DiamondLightSource/ptRecorder/docs/Hardware/Box/NewHole1.jpg

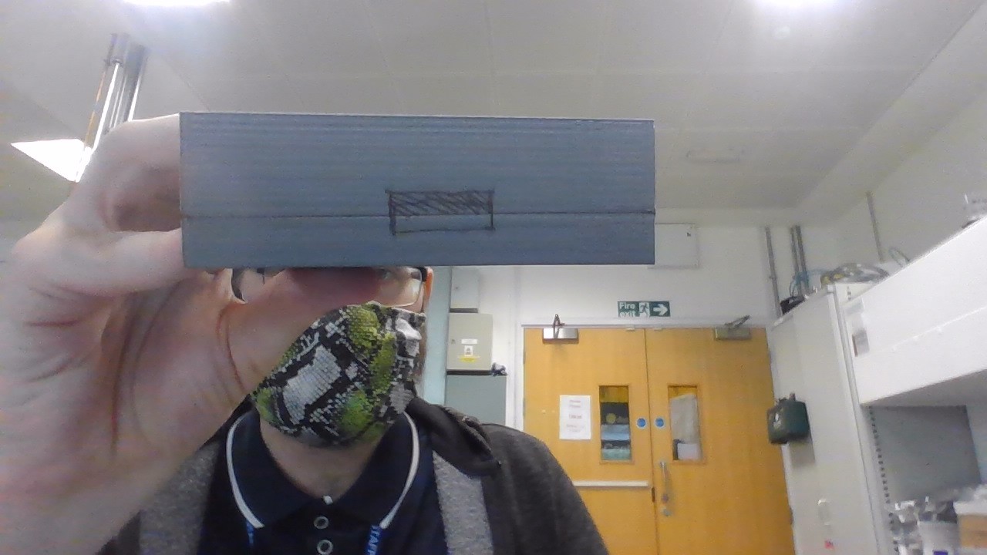
docs/Hardware/Box/NewHole1.jpg
