DiamondLightSource/ptRecorder/docs/Hardware/Box/NewHole2.jpg

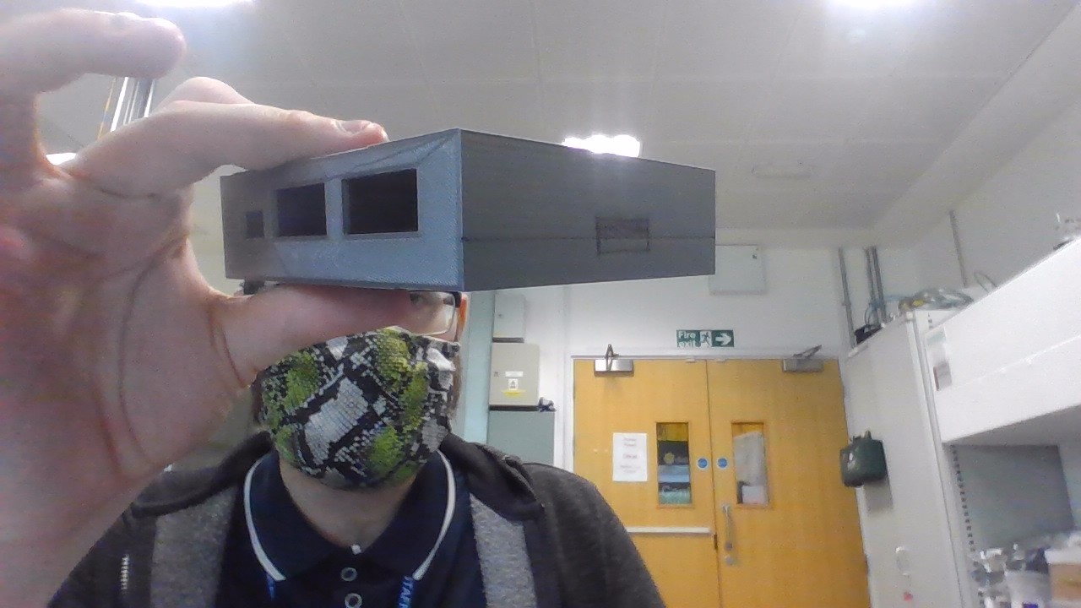
docs/Hardware/Box/NewHole2.jpg
