DiamondLightSource/ptRecorder/README.md

# ptRecorder
Pressure and Temperature recorder created by Daniel Brennand and comissioned by DLS Vacuum Dept.

### DLS Contacts

- Hugo Shiers
- Giles Knap
