DiamondLightSource/ptRecorder/docs/Hardware/Box/NewHoleDimensions.pdf

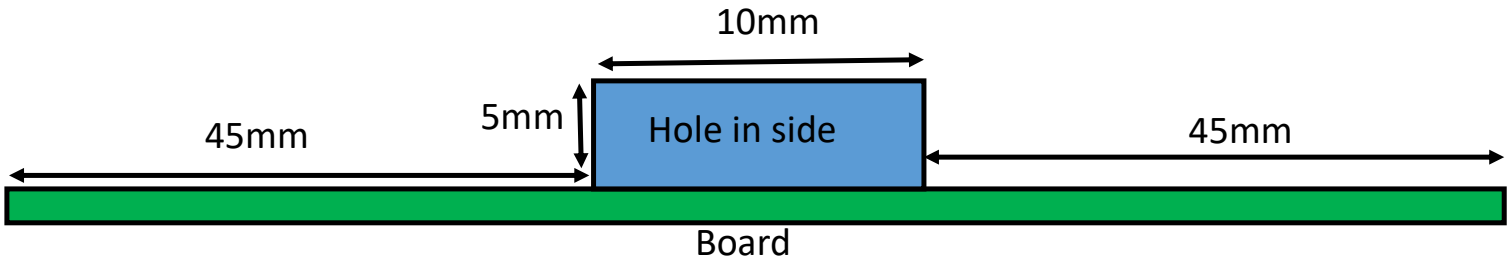
[picture p6: figure]
Board; Hole in side
