DiamondLightSource/ptRecorder/docs/Hardware/Box/Drawing1.pdf

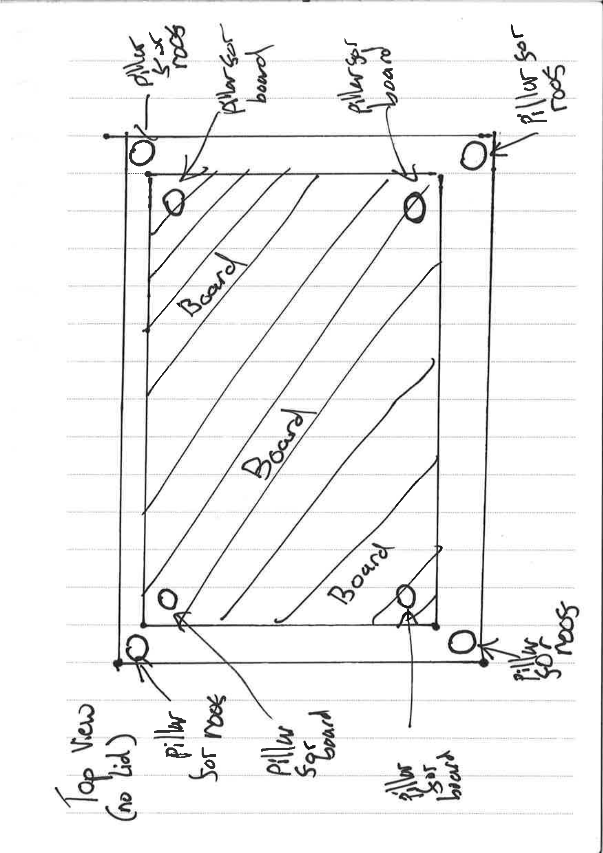
[picture p7: page 1]
