DiamondLightSource/ptRecorder/docs/Hardware/Box/Drawing2.pdf

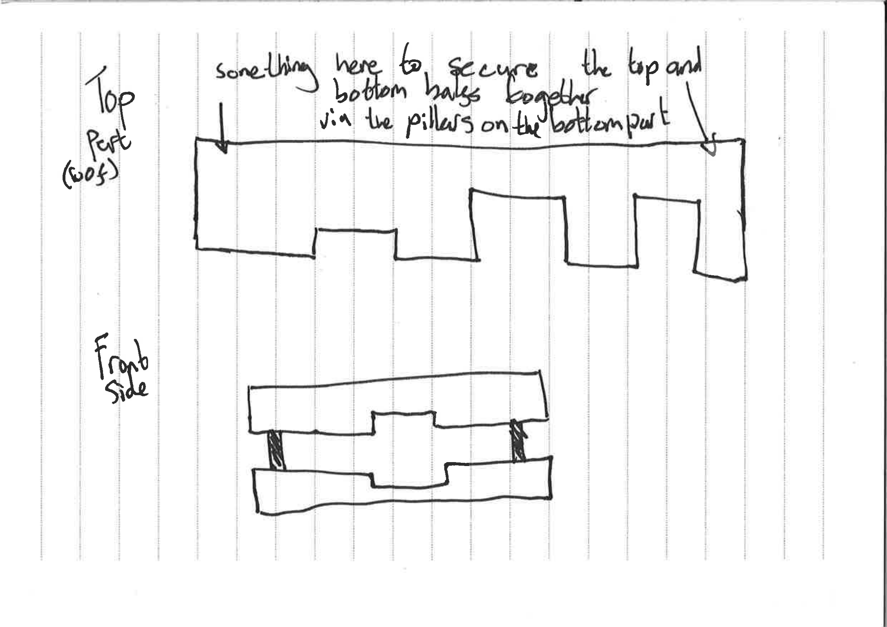
[picture p8: page 1]
