DiamondLightSource/ptRecorder/docs/Hardware/Box/Drawing3.pdf

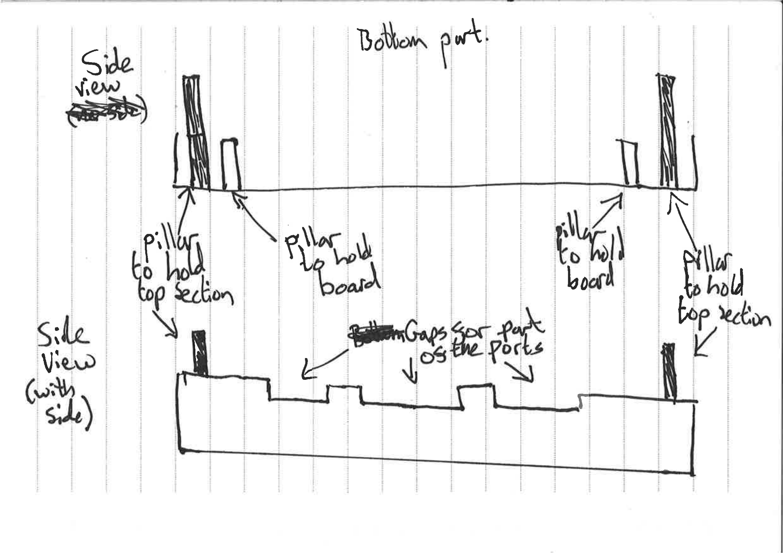
[picture p9: page 1]
