DiamondLightSource/ptRecorder/docs/Hardware/Parts&BOM/BOM.xlsx

Part Name | MFR Part number | Quantity | Designator | Value
ADC | ADS8332IBPWR | 2 | IC4, IC5
Reference IC | MCP1541T-I/TT | 2 | IC1, IC6
9 Pin connector | 9661127601 | 4 | J3, J4, J5, J5
Thermocouple Amp | MAX31855KASA+ | 2 | IC2, IC3
Thermocouple Conector | 381-7564 | 2 | J1, J2
Zener Diode | ESD12VD3B-TP | 14 | D1, D2, D3, D4, D5, D6, D7, D8, D9, D10, D11, D12, D13, D14
Resistor (1k) | ERJ-3GEYJ102V | 4 | R1, R16, R31, R32 | 1k
Resistor (2k) | RMCF0402FT2K00 | 14 | R2, R5, R7, R9, R11, R13, R15, R17, R20, R22, R24, R26, R28, R30 | 2k
Resistor (3k) | ERJ-6GEYJ302V | 14 | R3, R4, R6, R8, R10, R12, R14, R18, R19, R21, R23, R25, R27, R29 | 3k
Capacitor (0.1uF) | C0402C104K4PACTU | 2 | C3, C4 | 0.1uF
Capacitor (100pF) | C0402C101K5RAC7867 | 14 | C7, C8, C9, C10, C11, C12, C13, C16, C17, C18, C19, C20, C21, C22 | 100pF
Capacitor (10uF) | CL21A106KPCLQNC | 4 | C5, C6, C14, C15 | 10uF
Capacitor (1uF) | C0603C105K8RACTU | 4 | C1, C2, C23, C24 | 1uF
Capacitor (0.01uF) | CL05B103KB5VPJC | 2 | C25, C26 | 0.01uF
Capacitor (22uF) | CL21X226MRQNNNE | 2 | C27, C28 | 22uF
Seeduino Xiao | 1E4-D57-5A2 | 1 | U1
