DiamondLightSource/ptRecorder/docs/Hardware/Parts&BOM/Parts List.xlsx

Part Name | Value | MFR | MFR Part number | Supplier | Supplier Part Number | Quantity | Cost per unit* | Cost per board* | Designator | Details | Link
ADC |  | Texas Instruments | ADS8332IBPWR | DigiKey | 296-42323-1-ND | 2 | £7.37 | £14.74 | IC4, IC5 |  | https://www.digikey.co.uk/en/products/detail/texas-instruments/ADS8332IBPWR/5356909
Reference IC |  | Microchip | MCP1541T-I/TT | RS | 698-9047 | 2 | £0.70 | £1.40 | IC1, IC6 |  | https://uk.rs-online.com/web/p/voltage-references/6989047/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
9 Pin connector |  | Harting | 9661127601 | RS | 160-3060 | 4 | £3.48 | £13.92 | J3, J4, J5, J5 |  | https://uk.rs-online.com/web/p/d-sub-connectors/1603060
Thermocouple Amp |  | Maxim Integrated | MAX31855KASA+ | Mouser | 700-MAX31855KASA+ | 2 | £4.63 | £9.26 | IC2, IC3 |  | https://www.mouser.co.uk/ProductDetail/Maxim-Integrated/MAX31855KASA+/?qs=ffX8NcjNb2QF5YDuL5Qj5g==
Thermocouple Conector |  | RS | 381-7564 | RS | 381-7564 | 2 | £3.08 | £6.16 | J1, J2 |  | https://uk.rs-online.com/web/p/sensor-accessories/3817564
Zener Diode |  | Micro Commercial Co | ESD12VD3B-TP | DigiKey | ESD12VD3B-TPMSCT-ND | 14 | £0.17 | £2.38 | D1, D2, D3, D4, D5, D6, D7, D8, D9, D10, D11, D12, D13, D14 |  | https://www.digikey.co.uk/en/products/detail/micro-commercial-co/ESD12VD3B-TP/2783860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
Resistor | 1k | Bourns Inc. | CR0402AFX-1001GLF | DigiKey | 118-CR0402AFX-1001GLFTR-ND | 2 | £0.07 | £0.14 | R1, R16 |  | https://www.digikey.co.uk/en/products/detail/bourns-inc/CR0402AFX-1001GLF/12091350
Resistor | 2k | Stackpole Electronics Inc | RMCF0402FT2K00 | DigiKey | RMCF0402FT2K00CT-ND | 14 | £0.01 | £0.14 | R2, R5, R7, R9, R11, R13, R15, R17, R20, R22, R24, R26, R28, R30 |  | https://www.digikey.co.uk/en/products/detail/stackpole-electronics-inc/RMCF0402FT2K00/1761524
Resistor | 3k | Stackpole Electronics Inc | RMCF0402FT3K00 | DigiKey | RMCF0402FT3K00CT-ND | 14 | £0.07 | £0.98 | R3, R4, R6, R8, R10, R12, R14, R18, R19, R21, R23, R25, R27, R29 |  | https://www.digikey.co.uk/en/products/detail/stackpole-electronics-inc/RMCF0402FT3K00/2417444
Capacitor | 0.1uF | KEMET | C0402C104K4PACTU | DigiKey | 399-7762-1-ND | 2 | £0.03 | £0.06 | C3, C4 |  | https://www.digikey.co.uk/en/products/detail/kemet/C0402C104K4PACTU/2196232
Capacitor | 100pF | KEMET | C0402C101K5RAC7867 | DigiKey | 399-15291-1-ND | 14 | £0.01 | £0.14 | C7, C8, C9, C10, C11, C12, C13, C16, C17, C18, C19, C20, C21, C22 |  | https://www.digikey.co.uk/en/products/detail/kemet/C0402C101K5RAC7867/2269209
Capacitor | 10uF | Samsung Electro-Mechanics | CL05A106MP8NUB8 | DigiKey | 1276-6830-1-ND | 4 | £0.27 | £1.08 | C5, C6, C14, C15 |  | https://www.digikey.co.uk/en/products/detail/samsung-electro-mechanics/CL05A106MP8NUB8/5961314
Capacitor | 1uF | Samsung Electro-Mechanics | CL05A105KO5NNNC | DigiKey | 1276-1067-1-ND | 4 | £0.07 | £0.28 | C1, C2, C23, C24 |  | https://www.digikey.co.uk/en/products/detail/samsung-electro-mechanics/CL05A105KO5NNNC/3886725
Capacitor | 0.01uF | Samsung Electro-Mechanics | CL05B103KB5VPJC | DigiKey | 1276-CL05B103KB5VPJCCT-ND | 2 | £0.03 | £0.06 | C25, C26 |  | https://www.digikey.co.uk/en/products/detail/samsung-electro-mechanics/CL05B103KB5VPJC/11487809
Capacitor | 22uF | AVX Corporation | 04026D226MAT2A | DigiKey | 478-9839-1-ND | 2 | £0.49 | £0.98 | C27, C28 |  | https://www.digikey.co.uk/en/products/detail/avx-corporation/04026D226MAT2A/5964920
Seeduino Xiao |  | Seeduino | 1E4-D57-5A2 | UnmannedTech | 1E4-D57-5A2 | 1 | £4.49 | £4.49 | U1 |  | https://www.unmannedtechshop.co.uk/product/seeeduino-xiao-arduino-microcontroller/
 |  |  |  |  |  |  | Total: | £56.21
*Assuming an order of 14 boards
