DiamondLightSource/ptRecorder/docs/Hardware/Parts&BOM/Quick-teck BOM.xls

 |  | BOM list
Date: 11 Aug 2021
Qty | Reference Designator | Item Description | Supplier | Supplier Part no. | Manufacturer | Manufacturer Part no. | Comment
2 | IC4, IC5 | ADC | DigiKey | 296-42323-1-ND | Texas Instruments | ADS8332IBPWR
2 | IC1, IC6 | Reference IC | RS | 698-9047 | Microchip | MCP1541T-I/TT
4 | J3, J4, J5, J6 | 9 Pin connector | RS | 160-3060 | Harting | 9661127601
2 | IC2, IC3 | Thermocouple Amp | Mouser | 700-MAX31855KASA+ | Maxim Integrated | MAX31855KASA+
2 | J1, J2 | Thermocouple Conector | RS | 381-7564 | RS | 381-7564
14 | D1, D2, D3, D4, D5, D6, D7, D8, D9, D10, D11, D12, D13, D14 | Zener Diode | DigiKey | ESD12VD3B-TPMSCT-ND | Micro Commercial Co | ESD12VD3B-TP
4 | R1, R16, R31, R32 | Resistor | DigiKey | P1.0KGCT-ND | Panasonic Electronic Components | ERJ-3GEYJ102V | 1k
14 | R2, R5, R7, R9, R11, R13, R15, R17, R20, R22, R24, R26, R28, R30 | Resistor | DigiKey | RMCF0402FT2K00CT-ND | Stackpole Electronics Inc | RMCF0402FT2K00 | 2k
14 | R3, R4, R6, R8, R10, R12, R14, R18, R19, R21, R23, R25, R27, R29 | Resistor | DigiKey | P3.0KACT-ND | Panasonic Electronic Components | ERJ-6GEYJ302V | 3k
2 | C3, C4 | Capacitor | DigiKey | 399-7762-1-ND | KEMET | C0402C104K4PACTU | 0.1uF
14 | C7, C8, C9, C10, C11, C12, C13, C16, C17, C18, C19, C20, C21, C22 | Capacitor | DigiKey | 399-15291-1-ND | KEMET | C0402C101K5RAC7867 | 100pF
4 | C5, C6, C14, C15 | Capacitor | DigiKey | 1276-2402-1-ND | Samsung Electro-Mechanics | CL21A106KPCLQNC | 10uF
4 | C1, C2, C23, C24 | Capacitor | DigiKey | 399-11133-1-ND | KEMET | C0603C105K8RACTU | 1uF
2 | C25, C26 | Capacitor | DigiKey | 1276-CL05B103KB5VPJCCT-ND | Samsung Electro-Mechanics | CL05B103KB5VPJC | 0.01uF
2 | C27, C28 | Capacitor | DigiKey | 1276-1202-1-ND | Samsung Electro-Mechanics | CL21X226MRQNNNE | 22uF
1 | U1 | Seeduino Xiao | UnmannedTech | 1E4-D57-5A2 | Seeduino | 1E4-D57-5A2 | Will be provided
BOM lines |  | 16
Total components qty: |  | 85
Notes: 1. Please use this template to ask for assembly and/or components sourcing quotes. 2. You don't need to provide the 'Manufacturer' and 'Manufacturer part no.' information, if you use Quick-teck as the supplier(input 'Quick-teck in the 'Supplier' cell') 3. Quick-teck China factory have over 1500 different components in stock. These parts are most common and popular used in our China factory site.The average price for these components is just one third of Europe suppliers. The real time in stock information can be found from: http://www.quick-teck.co.uk/ElectronicElement/eeList.php 4. Any miss information or different format BOM file may result in additional engineering charges.
