DiamondLightSource/ptRecorder/docs/Hardware/Parts&BOM/Quotes.xlsx

Boards: | 14
 |  | Place | Total (Including Shipping) | Delivery Time | Online or Email | Manufacturing | Assembly | Components | Per Board
 |  | PCB Pool | £2025.72 | 16WD | Online | £20.50 | £54.24 | £69.95 | £144.69
 |  | Quick Tec | £1220.46 | 4-5Weeks | Email | £15.28 | £18.38 | £53.45 | £87.11
 |  | PCB Train | £2277.65 | 15WD | Online | £30.57 | £76.29 | £55.83 | £162.69 | W/o seed and thermo connector
 |  | HiTechCircuits | £976.19 | 3-4Weeks | Email | £5.05 | £0.71 | £45.10 | £50.86 | Possibly need to add import making it 1171.43 leading to 83.67
