DiamondLightSource/ptRecorder/docs/Hardware/DrawingFiles/9PinConnectorDimensions.pdf

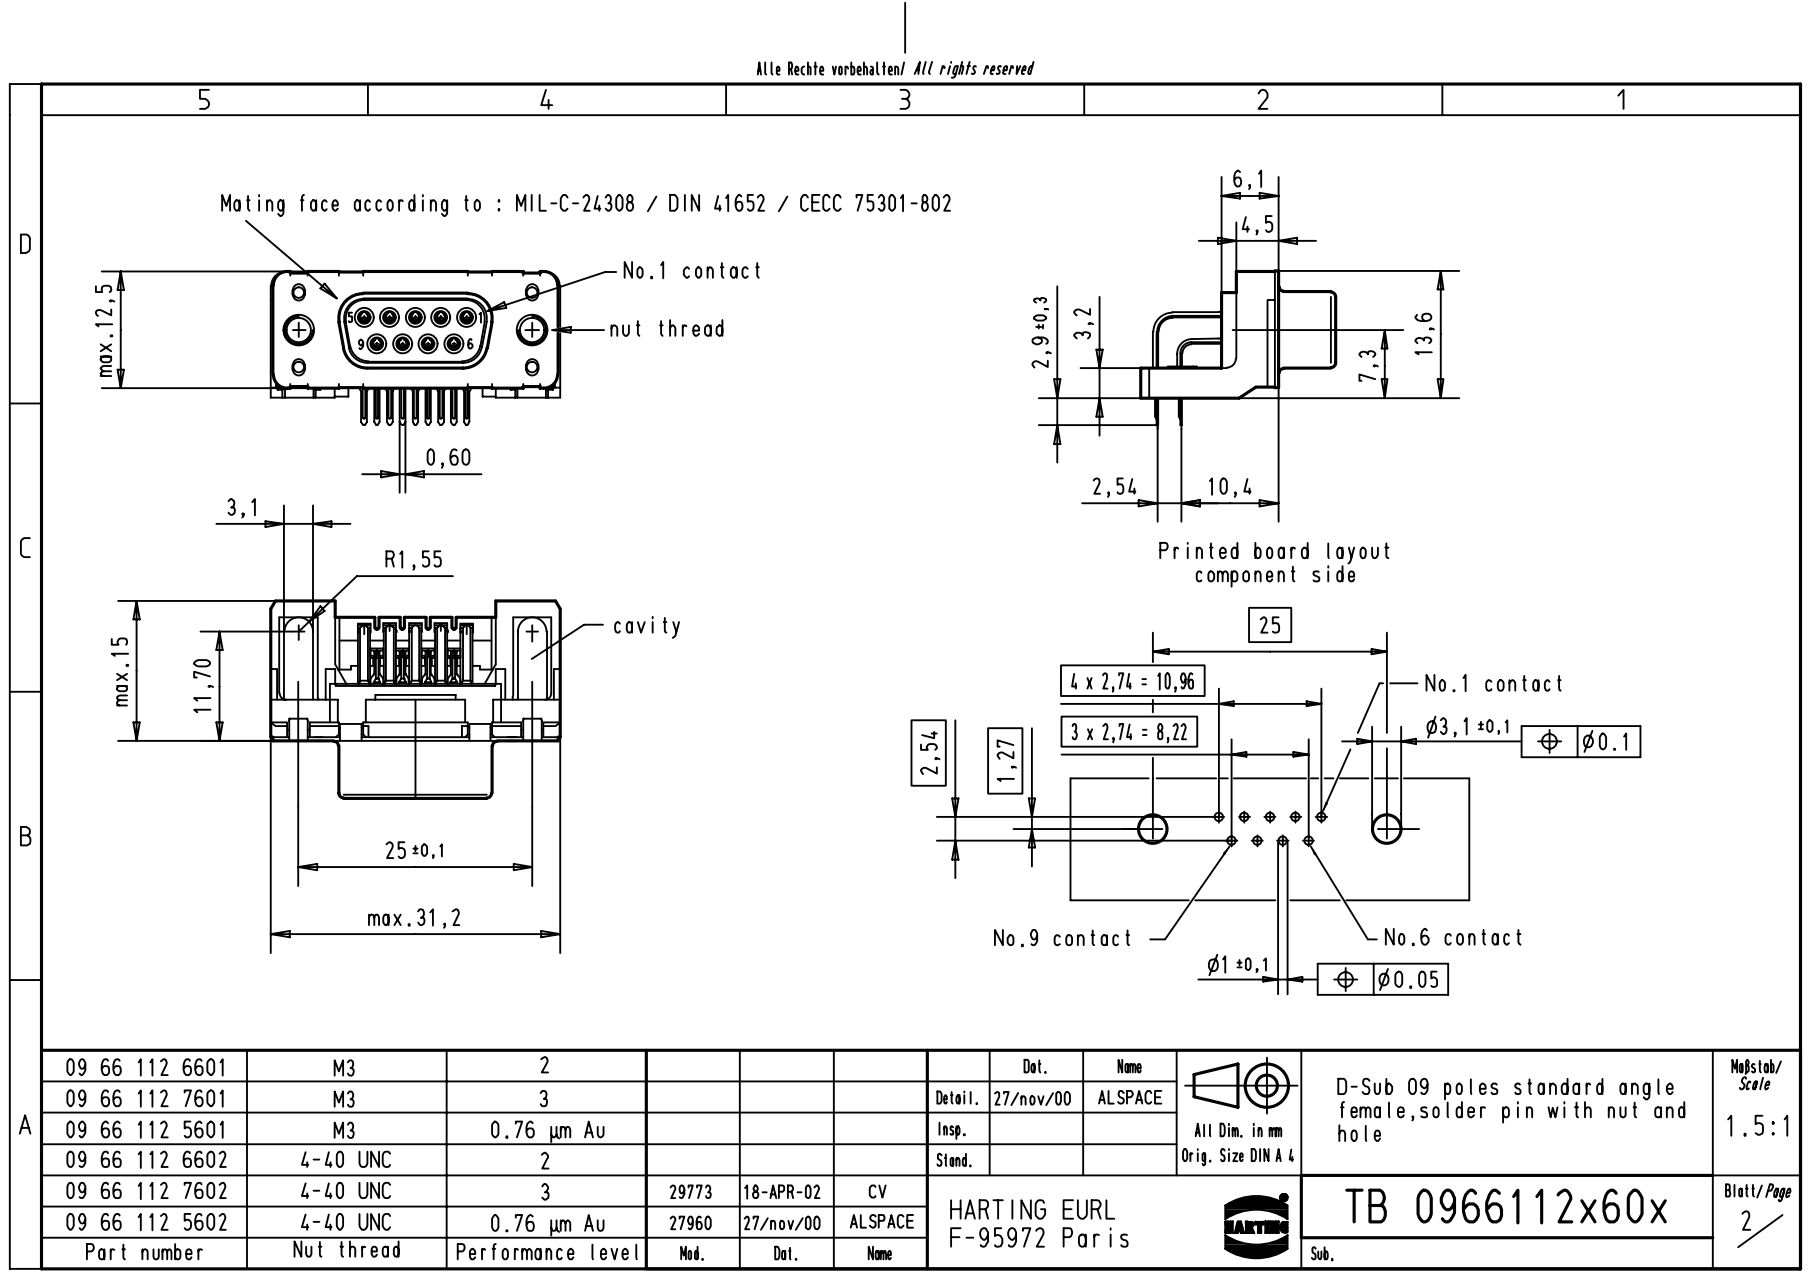
[picture p15: page 1]
