DiamondLightSource/ptRecorder/docs/Hardware/KiCadFiles/DataAqBoardV1.1.kicad_pcb

## KiCad design docs/Hardware/KiCadFiles/DataAqBoardV1.1.kicad_pcb (2021-11-04)

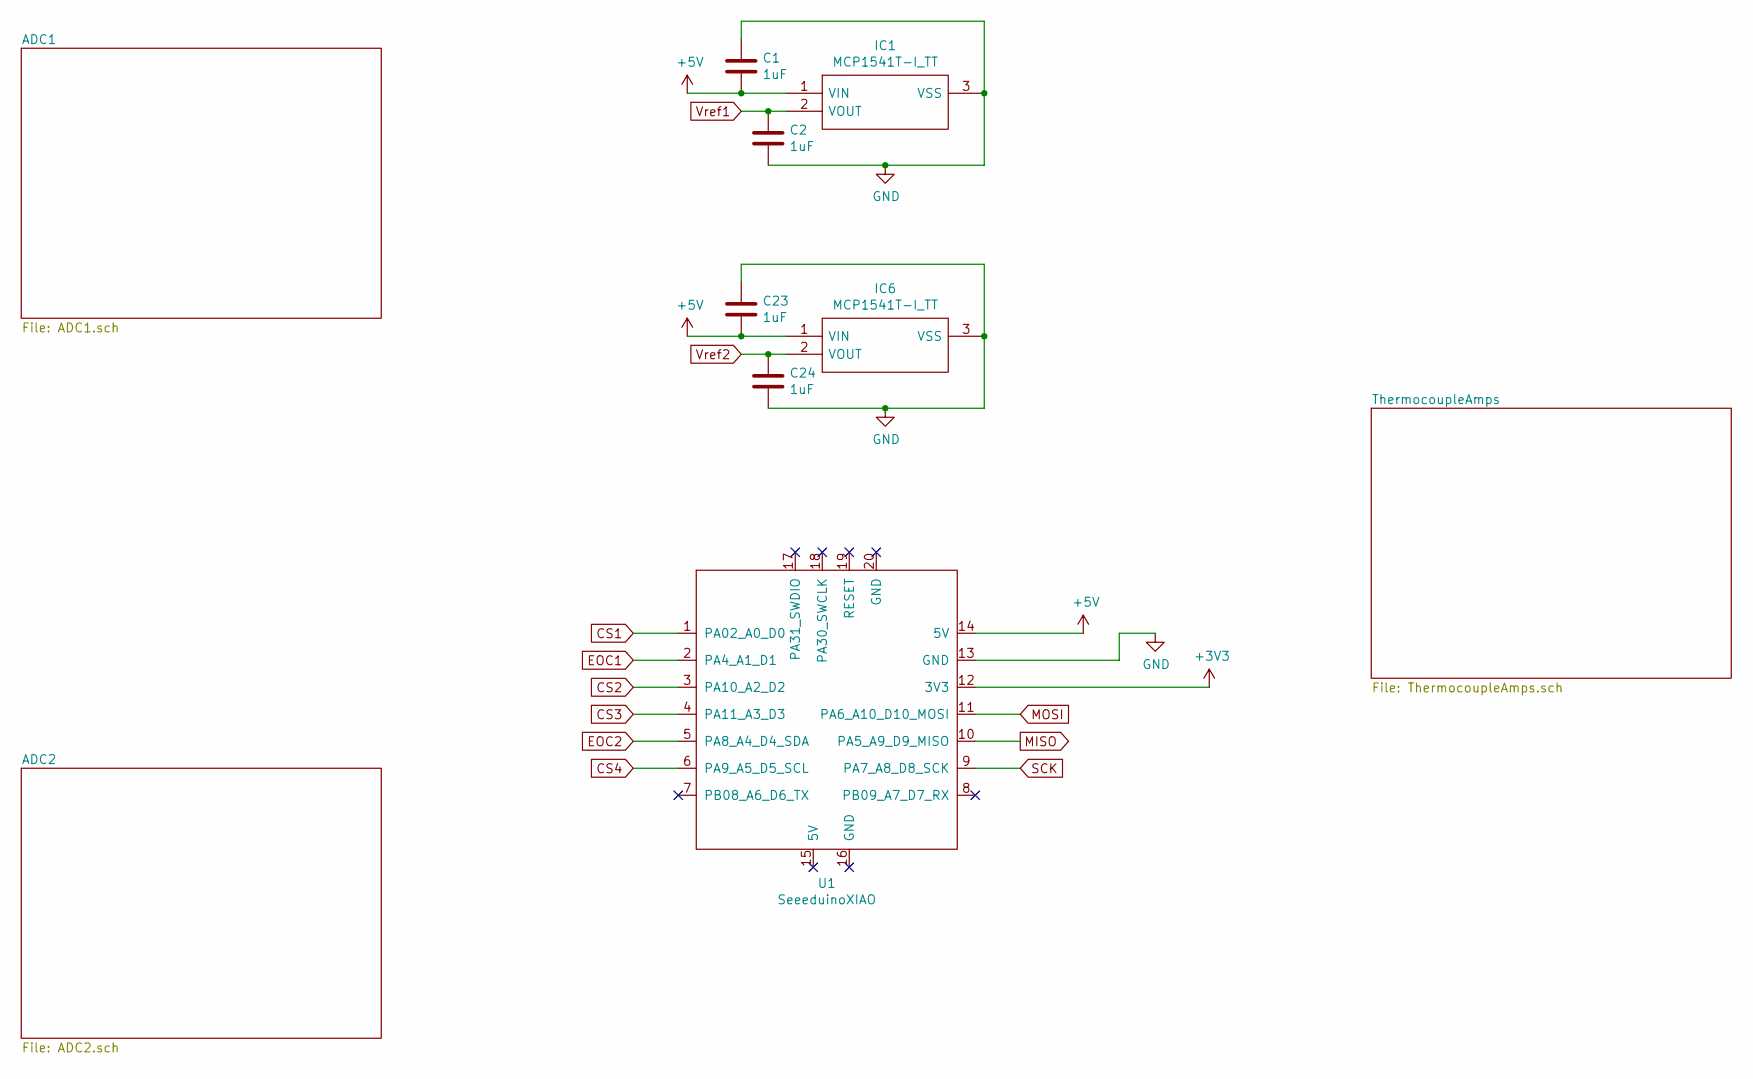
[picture p16: schematic DataAqBoardV1.1.sch, DAQ board]

Parts:
C1, C2, C23, C24: 1uF; C_0201_0603Metric
IC1, IC6: MCP1541T-I_TT; SOT96P237X112-3N; Manufacturer_Part_Number MCP1541T-I/TT
U1: SeeeduinoXIAO; Seeeduino XIAO-MOUDLE14P-2.54-21X17.8MM

Connections:
+3V3: U1.12 (3V3); also elsewhere on the board
+5V: C1.2, C23.2, IC1.1 (VIN), IC6.1 (VIN), U1.14 (5V); also elsewhere on the board
CS1: U1.1 (PA02_A0_D0); also elsewhere on the board
CS2: U1.3 (PA10_A2_D2); also elsewhere on the board
CS3: U1.4 (PA11_A3_D3); also elsewhere on the board
CS4: U1.6 (PA9_A5_D5_SCL); also elsewhere on the board
EOC1: U1.2 (PA4_A1_D1); also elsewhere on the board
EOC2: U1.5 (PA8_A4_D4_SDA); also elsewhere on the board
GND: C1.1, C2.2, C23.1, C24.2, IC1.3 (VSS), IC6.3 (VSS), U1.13 (GND); also elsewhere on the board
MISO: U1.10 (PA5_A9_D9_MISO); also elsewhere on the board
MOSI: U1.11 (PA6_A10_D10_MOSI); also elsewhere on the board
SCK: U1.9 (PA7_A8_D8_SCK); also elsewhere on the board
Vref1: C2.1, IC1.2 (VOUT); also elsewhere on the board
Vref2: C24.1, IC6.2 (VOUT); also elsewhere on the board

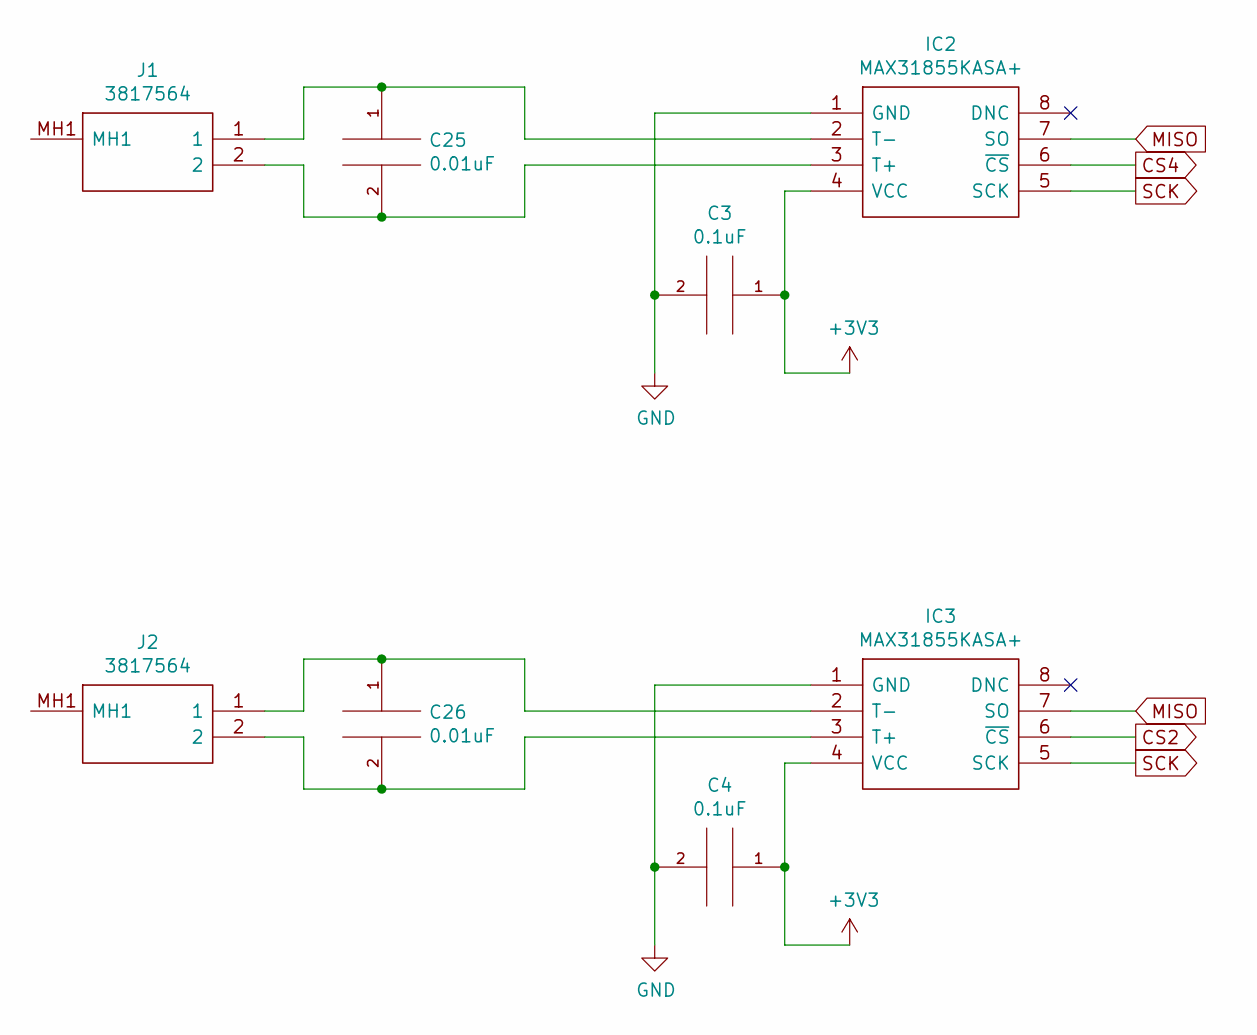
[picture p17: schematic ThermocoupleAmps.sch]

Parts:
C3, C4: 0.1uF; C_0201_0603Metric
C25, C26: 0.01uF; C_0201_0603Metric
IC2, IC3: MAX31855KASA+; SOIC127P600X175-8N; Manufacturer_Part_Number MAX31855KASA+
J1, J2: 3817564; Manufacturer_Part_Number 3817564

Connections:
+3V3: C3.1, C4.1, IC2.4 (VCC), IC3.4 (VCC); also elsewhere on the board
CS2: IC3.6 (~CS); also elsewhere on the board
CS4: IC2.6 (~CS); also elsewhere on the board
GND: C3.2, C4.2, IC2.1 (GND), IC3.1 (GND); also elsewhere on the board
MISO: IC2.7 (SO), IC3.7 (SO); also elsewhere on the board
unnamed: C25.1, IC2.2 (T-), J1.1
unnamed: C25.2, IC2.3 (T+), J1.2
unnamed: C26.1, IC3.2 (T-), J2.1
unnamed: C26.2, IC3.3 (T+), J2.2
SCK: IC2.5 (SCK), IC3.5 (SCK); also elsewhere on the board

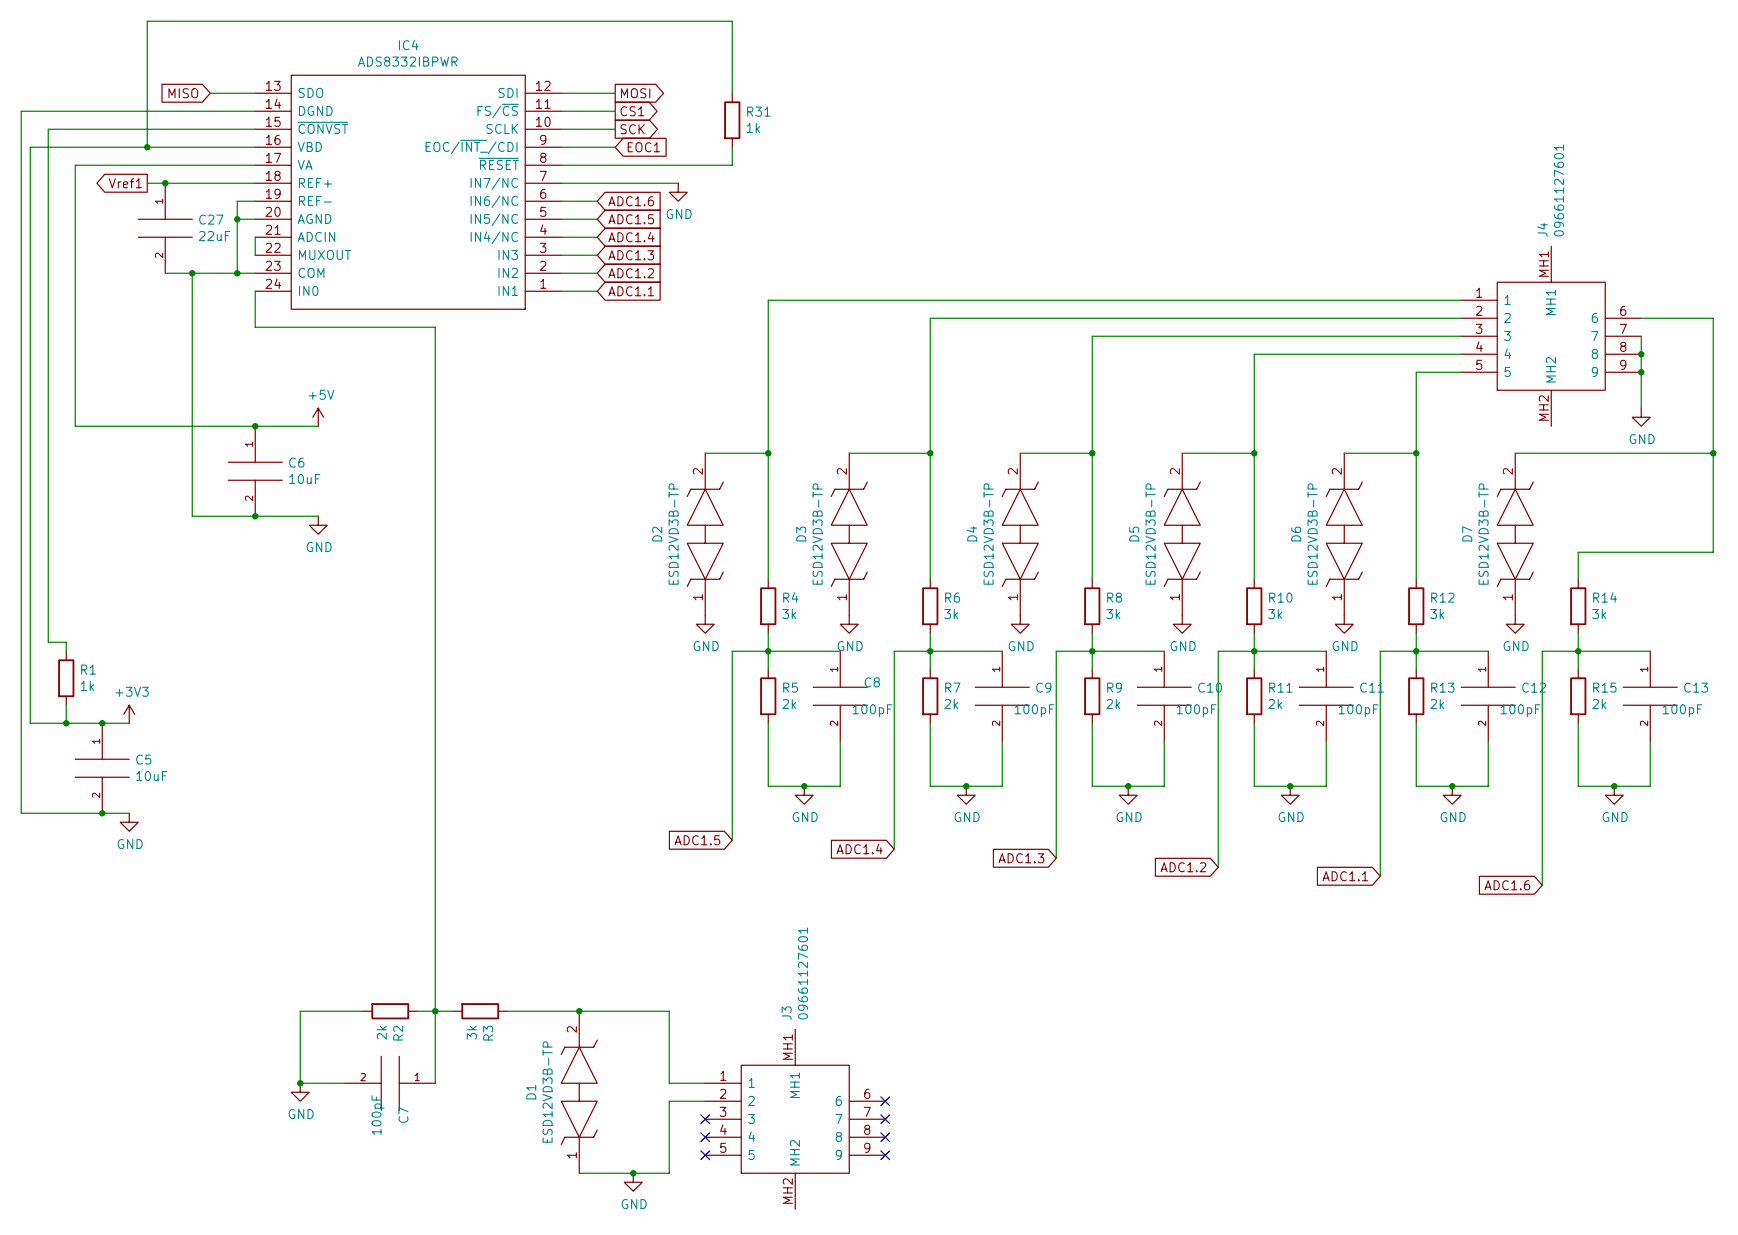
[picture p18: schematic ADC1.sch]

Parts:
C5, C6: 10uF; C_0201_0603Metric
C7, C8, C9, C10, C11, C12, C13: 100pF; C_0201_0603Metric
C27: 22uF; C_0201_0603Metric
D1, D2, D3, D4, D5, D6, D7: ESD12VD3B-TP; SOD2512X115N; Manufacturer_Part_Number ESD12VD3B-TP
IC4: ADS8332IBPWR; SOP65P640X120-24N; Manufacturer_Part_Number ADS8332IBPWR
J3, J4: 09661127601; 09661126600; Manufacturer_Part_Number 09661127601
R1, R31: 1k; R_0201_0603Metric
R2, R5, R7, R9, R11, R13, R15: 2k; R_0201_0603Metric
R3, R4, R6, R8, R10, R12, R14: 3k; R_0201_0603Metric

Connections:
+3V3: C5.1, IC4.16 (VBD), R1.2, R31.1; also elsewhere on the board
+5V: C6.1, IC4.17 (VA); also elsewhere on the board
ADC1.1: C12.1, IC4.1 (IN1), R12.2, R13.1
ADC1.2: C11.1, IC4.2 (IN2), R10.2, R11.1
ADC1.3: C10.1, IC4.3 (IN3), R8.2, R9.1
ADC1.4: C9.1, IC4.4 (IN4/NC), R6.2, R7.1
ADC1.5: C8.1, IC4.5 (IN5/NC), R4.2, R5.1
ADC1.6: C13.1, IC4.6 (IN6/NC), R14.2, R15.1
CS1: IC4.11 (FS/~CS); also elsewhere on the board
EOC1: IC4.9 (EOC/~INT_~/CDI); also elsewhere on the board
GND: C5.2, C6.2, C7.2, C8.2, C9.2, C10.2, C11.2, C12.2, C13.2, C27.2, D1.1, D2.1, D3.1, D4.1, D5.1, D6.1, D7.1, IC4.7 (IN7/NC), IC4.14 (DGND), IC4.19 (REF-), IC4.20 (AGND), IC4.23 (COM), J3.2, J4.7, J4.8, J4.9, R2.2, R5.2, R7.2, R9.2, R11.2, R13.2, R15.2; also elsewhere on the board
MISO: IC4.13 (SDO); also elsewhere on the board
MOSI: IC4.12 (SDI); also elsewhere on the board
unnamed: C7.1, IC4.24 (IN0), R2.1, R3.2
unnamed: D1.2, J3.1, R3.1
unnamed: D2.2, J4.1, R4.1
unnamed: D3.2, J4.2, R6.1
unnamed: D4.2, J4.3, R8.1
unnamed: D5.2, J4.4, R10.1
unnamed: D6.2, J4.5, R12.1
unnamed: D7.2, J4.6, R14.1
unnamed: IC4.8 (~RESET), R31.2
unnamed: IC4.15 (~CONVST), R1.1
unnamed: IC4.21 (ADCIN), IC4.22 (MUXOUT)
SCK: IC4.10 (SCLK); also elsewhere on the board
Vref1: C27.1, IC4.18 (REF+); also elsewhere on the board

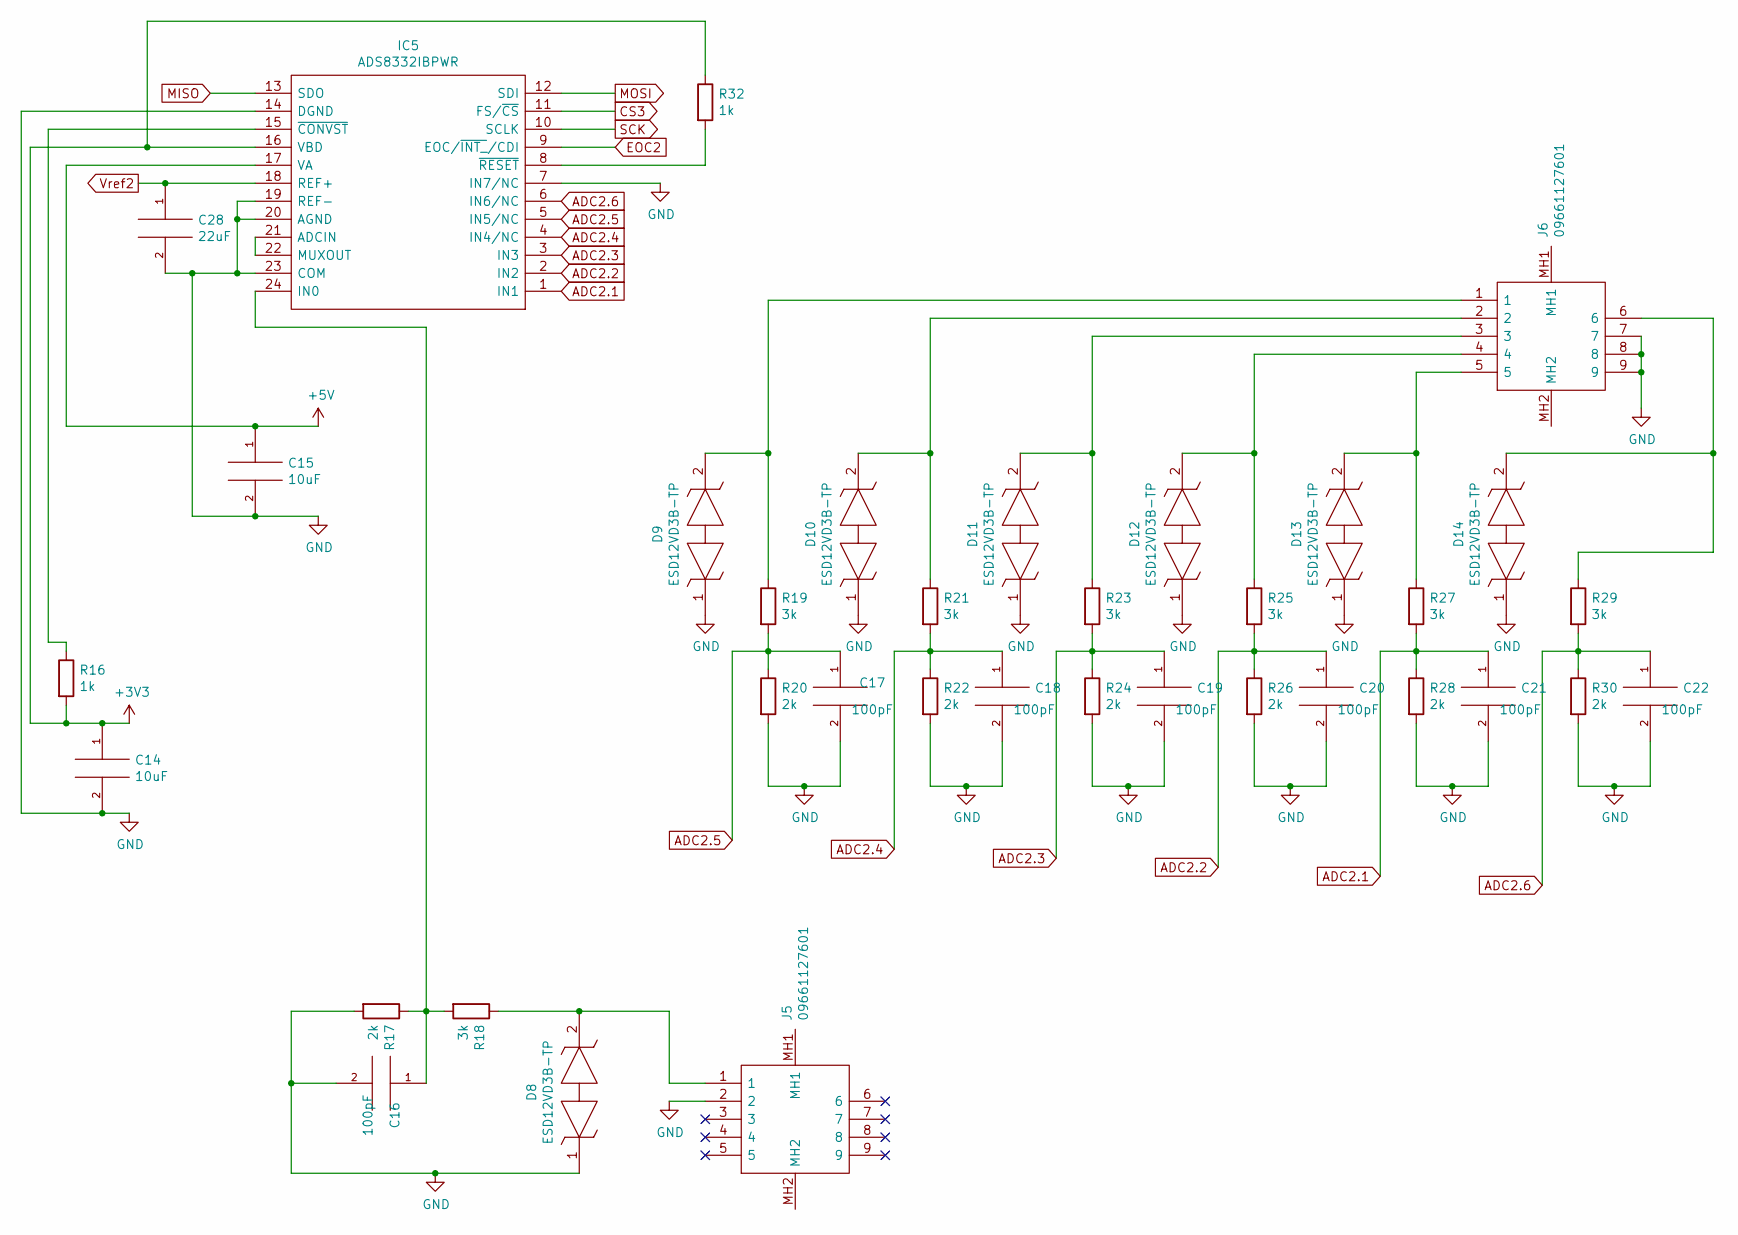
[picture p19: schematic ADC2.sch]

Parts:
C14, C15: 10uF; C_0201_0603Metric
C16, C17, C18, C19, C20, C21, C22: 100pF; C_0201_0603Metric
C28: 22uF; C_0201_0603Metric
D8, D9, D10, D11, D12, D13, D14: ESD12VD3B-TP; SOD2512X115N; Manufacturer_Part_Number ESD12VD3B-TP
IC5: ADS8332IBPWR; SOP65P640X120-24N; Manufacturer_Part_Number ADS8332IBPWR
J5, J6: 09661127601; 09661126600; Manufacturer_Part_Number 09661127601
R16, R32: 1k; R_0201_0603Metric
R17, R20, R22, R24, R26, R28, R30: 2k; R_0201_0603Metric
R18, R19, R21, R23, R25, R27, R29: 3k; R_0201_0603Metric

Connections:
+3V3: C14.1, IC5.16 (VBD), R16.2, R32.1; also elsewhere on the board
+5V: C15.1, IC5.17 (VA); also elsewhere on the board
ADC2.1: C21.1, IC5.1 (IN1), R27.2, R28.1
ADC2.2: C20.1, IC5.2 (IN2), R25.2, R26.1
ADC2.3: C19.1, IC5.3 (IN3), R23.2, R24.1
ADC2.4: C18.1, IC5.4 (IN4/NC), R21.2, R22.1
ADC2.5: C17.1, IC5.5 (IN5/NC), R19.2, R20.1
ADC2.6: C22.1, IC5.6 (IN6/NC), R29.2, R30.1
CS3: IC5.11 (FS/~CS); also elsewhere on the board
EOC2: IC5.9 (EOC/~INT_~/CDI); also elsewhere on the board
GND: C14.2, C15.2, C16.2, C17.2, C18.2, C19.2, C20.2, C21.2, C22.2, C28.2, D8.1, D9.1, D10.1, D11.1, D12.1, D13.1, D14.1, IC5.7 (IN7/NC), IC5.14 (DGND), IC5.19 (REF-), IC5.20 (AGND), IC5.23 (COM), J5.2, J6.7, J6.8, J6.9, R17.2, R20.2, R22.2, R24.2, R26.2, R28.2, R30.2; also elsewhere on the board
MISO: IC5.13 (SDO); also elsewhere on the board
MOSI: IC5.12 (SDI); also elsewhere on the board
unnamed: C16.1, IC5.24 (IN0), R17.1, R18.2
unnamed: D8.2, J5.1, R18.1
unnamed: D9.2, J6.1, R19.1
unnamed: D10.2, J6.2, R21.1
unnamed: D11.2, J6.3, R23.1
unnamed: D12.2, J6.4, R25.1
unnamed: D13.2, J6.5, R27.1
unnamed: D14.2, J6.6, R29.1
unnamed: IC5.8 (~RESET), R32.2
unnamed: IC5.15 (~CONVST), R16.1
unnamed: IC5.21 (ADCIN), IC5.22 (MUXOUT)
SCK: IC5.10 (SCLK); also elsewhere on the board
Vref2: C28.1, IC5.18 (REF+); also elsewhere on the board

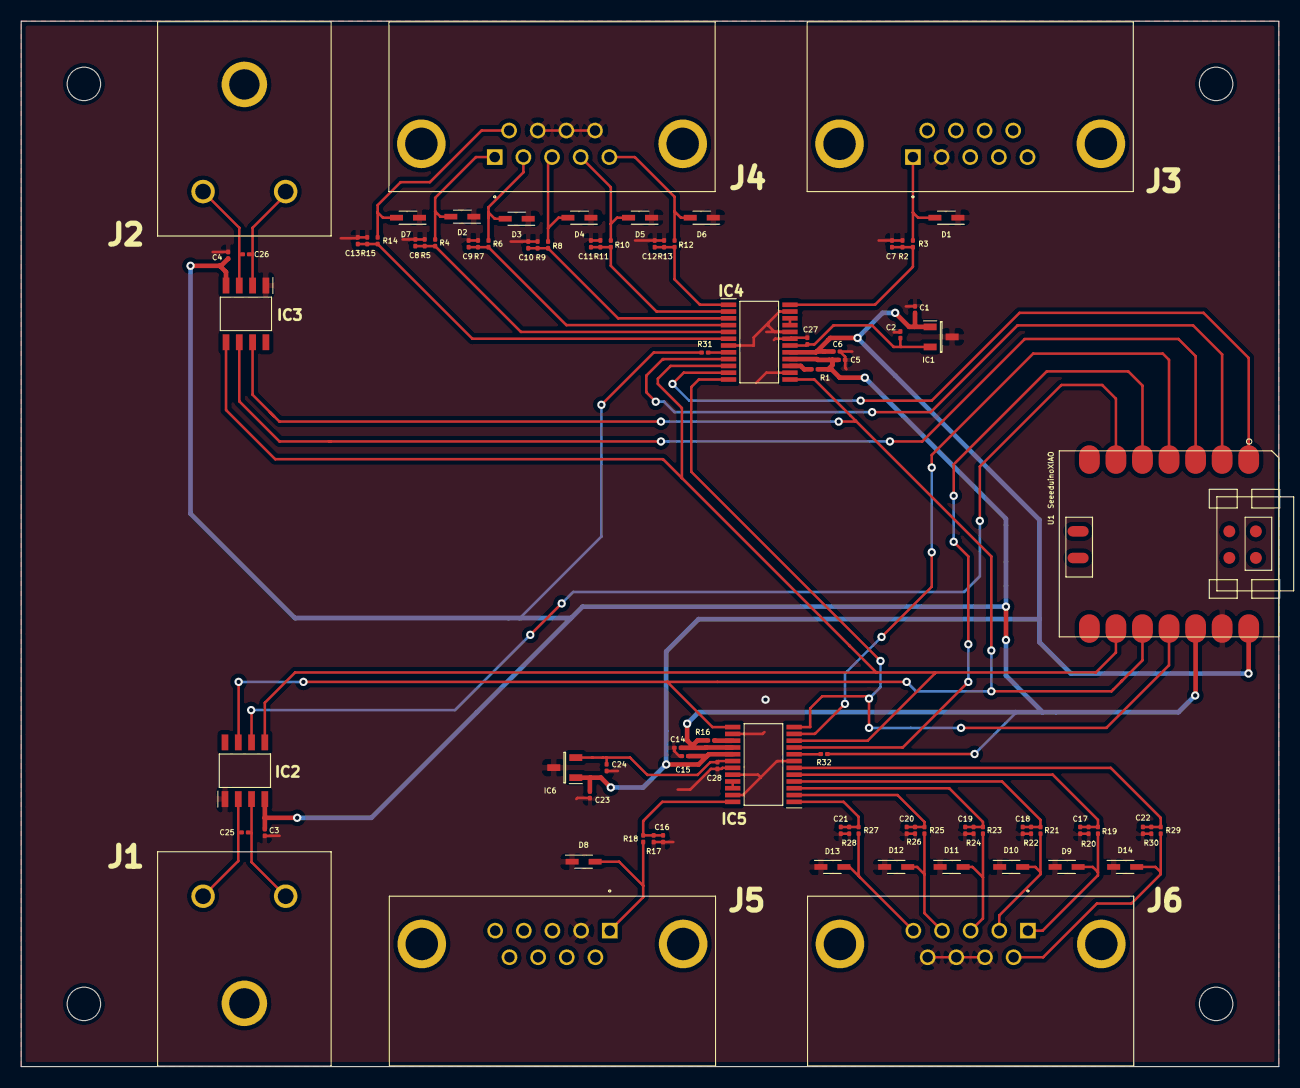
[picture p20: board DataAqBoardV1.1.kicad_pcb from above]

Board: 2 copper layers, 120.3 x 100.0 mm, 87 parts (0 on the bottom side), 52 nets.
