DiamondLightSource/ptRecorder/(commit log)

2021-11-04 initial version
    [ADC1.sch, ADC2.sch, BOM.xlsx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]
2021-12-17 Fixed several ui label mistakes and fixed conversion errors
    Several ui labels for the ports were mislabeled and have now been corrected.
    Added a tag to the end of each of the channel labels denoting the port they are connected to (I.e. P1 for port 1 etc)
    Added a new conversion (Conversion 0) to represent simply keeping the raw voltages and updated where the data is converted and the desired conversion selected to incorperate this now.
    [DAQCompanion.py]
2022-02-02 Fixed thermo voltage conversion, fullscreen bug
    Fixed the thermocouple voltage conversion,
    Set fullscreen hopefully stopping the gui text crash
    Changed Dev button to exit button
    [DAQCompanion.py]
